Twotoz/C5VRX/v5/README.md

# C5VRX-5

Analog 5.8 GHz FPV receiver on one Seeed Studio XIAO ESP32-C5 with a passive
6-bit resistor DAC: live FM video in, composite PAL/NTSC out for goggles.

C5VRX-5 uses one live demodulator. Its receive-chain evidence is recorded in
[docs/FINDINGS.md](docs/FINDINGS.md). Console `J` additionally enables the
read-only [IQLaneFusion research shadow](docs/IQLANE_FUSION.md): analytic
model proposals, off by default, with no lane/gain/decoder actuator. This
research is not a demonstrated video or range improvement.

## Experimental stacked PR

This branch contains an opt-in **U85G near-origin pair assistance** test on the freshly
measured WIDE VTX profile. Other profiles keep U85Q. The physical
pipeline is unchanged; outdoor range improvement is not measured, and
some synthetic echo/fade cases regress. Read [PAIR_DEMOD.md](docs/PAIR_DEMOD.md)
before the A/B test. The default build keeps the exact #196 demodulator. Build with
`-DC5VRX5_PAIR_ASSIST=ON` to test U85G on WIDE profiles. This experiment is not ready for production.

The branch also includes an [offline demod architecture search](docs/DEMOD_SEARCH.md).
It generates phase-only and predictive phase/frequency models within one 2 KiB
shared LUT, then rejects candidates that lose sync or strong-signal quality.
Screening uses the actual ADC folding; independent full-field tests gate export.
Running the search does not change the active firmware demodulator.
`lut_evolve.py` additionally evolves the complete LUT and arbitrary input-bit
selection, without requiring angular tokens or phase/frequency state meanings.
The follow-up explores 2..10-bit observation tokens and up to eight retained
state bits using unused DAC padding. Its 434-genome full-field run found no
passing LUT. A separate floating predictive host reference passes synthetic
quality/sync gates with +2.6..3.1 dB mean weak-case luma SINAD gain. This is a
research target, not live C5 firmware or measured outdoor range.

## Experimental AWD6 demodulator (opt-in)

[AWD6](docs/AWD6.md) is a new TX BitScrambler demodulator for **wide VTXs**:
the 50-ns phase step from counter A, with its half-turn ambiguity resolved
around a slowly tracked centre. Same pipeline, cadence and DAC window as
U85Q. Console `W` selects it for the WIDE profile (stored, reboots); every
other profile keeps U85Q. Host simulation only so far; not yet tested on a
board and no range claim.

## What it does

- **U85Q demodulator** in the TX BitScrambler: an untrained 32-phase tracker
  that keeps the picture locked across VTX deviations, off-centre carriers
  and multipath instead of dropping out. Board-validated on real video.
- **Fixed ultrafine IQ** (ADC bits 9,6,5,4) at 40 MS/s, no CPU in the sample
  path.
- **Direct Gain V5**: firmware gain with a zero-write healthy band, fast
  overload handling and a learned, persisted gain map.
- **Narrow analog filter**, measured once per board at startup: the lowest
  noise bandwidth that still passes 12 MHz (plus a 10 MHz class for
  low-deviation VTXs; simulation-based, board test pending).
- **Calibration only at startup**: anything that interrupts the picture
  runs once after power-on (only what is missing) or from the menu item
  CALIBRATE, never during flight. The goggles show what it does and how long.
- **VTX-matched profile** (narrow for low-deviation VTXs, wide 16 MHz for
  wide ones) **only from a fresh measurement**: every boot starts
  with the default profile; the narrow profile is chosen only when this
  boot measured the VTX in the startup phase. Later readings are kept as
  pending for the next boot, never switched in flight.
- **Field diagnostics** (serial `D`, `R`): what is really active, and why
  each dropout happened as far as the receiver can tell
  ([docs/FIELD_TEST.md](docs/FIELD_TEST.md)).
- **DC correction for every gain row, also with the VTX on**: missing rows
  are measured once at startup on a quiet channel, so far-out (high gain)
  reception has no uncorrected DC.
- **Automatic receive-chain care**: per-gain DC correction, DC drift
  tracking, sampling-phase check, AFC that centres the VTX.
- **Simple menu**: band, channel, scan, video standard, exit.

## Hardware

XIAO ESP32-C5. DAC on D4..D9 (GPIO 23, 24, 11, 12, 8, 9; LSB first) with
8.2k / 3.9k / 2k / 1k / 470R / 240R and a 200R load, as in C5VRX-3/4. The
receiver uses the ESP32-C5's own Wi-Fi radio; no extra RF parts.

## First boot

1. Flash (below) and power the receiver, best with the **VTX off**, for up
   to two minutes: the goggles show CALIBRATING with the time left. With a
   VTX on it calibrates the filter on a quiet channel and comes back.
   Results are stored; later boots skip what is already measured.
2. Switch the VTX on. Without a stored channel the receiver starts on
   A1 (5865 MHz); use the menu or scan to find yours.

## Controls (BOOT button)

| live video | in the menu |
| --- | --- |
| short press: next channel in the band | short press: next item |
| hold 0.6 s: open the menu | hold 0.6 s: do the item |

Menu items: **BAND** (next band), **CHANNEL** (next channel), **SCAN**
(all 48 channels, picks the strongest centred analog video), **VIDEO**
(AUTO / NTSC / PAL for the menu picture; AUTO follows the camera),
**CALIBRATE** (on the ground: measure again), **EXIT**.
The menu closes by itself after 30 s without a press.

## Flashing

- **Web flasher**: [twotoz.github.io/C5VRX](https://twotoz.github.io/C5VRX/),
  tab **C5VRX-5**, *Full firmware* when coming from another generation.
- **ESP-IDF 6.0.2**: `cd v5 && idf.py build flash`. The filter and DC
  correction need the exact libphy of IDF 6.0.2 (checked at build time);
  with another PHY they are disabled and the build warns.
- A running receiver enters USB download mode from the console key `` ` ``
  (`tools/enter_download.py`), so no BOOT button is needed for flashing.

## Serial console (USB, 115200)

`T` status, `D` range/health report, `R` per-second FIELD_DIAG lines on/off
(`tools/field_diag_compare.py`), `I` IQ snapshot
(`tools/capture_iq_snapshot.py`), `o` menu, `c` next channel, `b` next band,
`s` scan, `F` calibrate again (as the menu item), `L` bench-only IQ lane
comparison (video stops ~3 s), `` ` `` download mode, `h` help.

## Credits and license

C5VRX-5 is part of [C5VRX](https://github.com/Twotoz/C5VRX) by Twotoz and
the C5VRX contributors; the official website
([twotoz.github.io/C5VRX](https://twotoz.github.io/C5VRX/)) has the project
and its Discord invite. It builds on C5VRX-2..4 (the continuous MODEM_DIAG
to BitScrambler video path, Direct Gain V3-V5, the PAIR schedule and the
U85Q study of PR #190), on zerowidth/C5VRX PR #3 (interference-burst gate,
sampling-phase probe, off-grid channel tuning), on Louis Hitchcock's staged
overload recovery (C5VRX #182/#184), and on ESPARGOS esp-sdr (GPL-3.0) for
the C5 RX filter control. Espressif supplied the GDMA EOF fix
(espressif/esp-idf#19091).

Like the rest of this repository, C5VRX-5 is licensed under
**GPL-3.0-only** (see `LICENSE` at the repository root). The GPL allows
commercial use, including selling receivers with this firmware, provided
the source (with your changes) is passed on under the same license.
