Twotoz/C5VRX/v5/research/README.md

# Where can C5VRX-5 firmware still gain range?

For the follow-up automated **architecture search**, see
[DEMOD_SEARCH.md](../docs/DEMOD_SEARCH.md) and `demod_search.py`. It uses the
actual ultrafine folding quantizer and per-case sync/quality rejection gates.
The older tables below retain their original clipped-quantizer assumptions;
they are not measured receiver sensitivity or a guarantee of field range.

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

## 1. Sync is not the bottleneck

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

## 2. The picture limit depends on the VTX deviation

Usable threshold, then the combined range limit (worse of lock/usable):

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

## 3. Strong signal and carrier error (`data/strong.txt`)

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

## 4. Tracker gain alone (`data/tracker.txt`)

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

## 5. What C5VRX-5 does with it

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

## 6. Open field: AFC re-acquisition at weak signal (`afc_bias.py`)

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

### Coherence is not C/N

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

## 7. Open field: propagation, the larger effect

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

## 8. Open field: Direct Gain through fast nulls (`test/test_gain_fade.c`)

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

## 9. Open field: what gives the most range (`field_antenna.py`)

This section uses textbook physics and data from datasheets and listings,
not C5VRX measurements.

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

Model ranges (25 mW, 2 dBi RHCP VTX, -93 dBm, 95 % of positions):

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

**Other levers.**

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

## 10. Wide VTXs: the default 12 MHz class clips them (`range_study.py wide`)

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

## 11. Where it is good and where it is bad (`situations.py`)

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

**Bad, and what was done about it:**

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

## Not firmware levers

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

## Reproduce

```
python range_study.py filter  data/filter.json
python range_study.py sync    data/sync.json
python range_study.py tracker data/tracker.json
python range_study.py matched data/matched.json
CNRS=0,2,4,8,12,16,20,25 python range_study.py strong data/strong.json
```

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

## Diagnostic cliff follow-up (PR #196, 2026-10-11)

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

See `v5/docs/FIELD_TEST.md` for repeated 0.5–1-dB conducted attenuation sweeps,
independent IQ/video/output thresholds, real-IQ floating/bit-exact replay and
outdoor antenna/height A/B/A. RF offset readback, analog BW/passband and DC
validity across profiles still require bench measurements. No measured range
gain or physical picture-cliff fix is claimed by the diagnostic code.

## 10. Demodulator follow-up: U85G (draft, opt-in)

The stacked #196 follow-up screened 252 analytic formulas and built a
near-origin-only PAIR4411 decoder that uses B's signs. Independent full
PAL/NTSC rasters show small AWGN gains on wide VTXs, but a synthetic echo
case regresses badly in sync. It is consequently **OFF by default**, not
a claimed field-range fix. See [PAIR_DEMOD.md](../docs/PAIR_DEMOD.md) for
numbers, rejected candidates, the generator, reproducible data and the
physical A/B gate. Medium/narrow firmware profiles keep U85Q even in an
opt-in build.
