Twotoz/C5VRX/v5/docs/IQLANE_FUSION.md

# IQLaneFusion: analytic research implementation

C5VRX by Twotoz and the C5VRX contributors. This extends the untrained
U85/PAIR formula work in PR #190, the older adaptive lane/gain controller,
and the Gaussian-cell/history study in `experiments/c5vrx-4/PHASE8_THREE_BUNDLE.md`.
Source: https://github.com/Twotoz/C5VRX . Official project and Discord invite:
https://twotoz.github.io/C5VRX/ . Existing GPL/source notices remain applicable.

## Implemented, and what is not proved

The host implementation is executable: exact Q10 bit extraction, union-cell
Gaussian likelihood integration, a factorized phase/frequency tracker retaining
multiple hypotheses, mathematical candidate/gain search, sequential route-write
replay, decision persistence, U85Q comparisons and a compressed BS experiment
generator. No fitted weights, camera training or online reward learner.

Firmware has an opt-in passive shadow, not live lane fusion. `J` toggles it;
`T` reports it. It consumes 64 bytes sampled from the existing completed
control snapshot at most once per second. There are no extra IQ copies and no
actuator calls. The normal fixed-ultrafine U85Q path is unchanged. Hardware
timing, real displayed video and RF attenuation/range are not validated here.

The reference is NOT a demonstrated replacement for U85Q. The synthetic
fade probe currently regresses substantially despite improvements in some
nominal/weak/fold cases. That negative result is preserved in the JSON report.
The physical-ADC moving PAL test at synthetic C/N6, seed196, 64 phases,
known amplitude/noise and one fixed gain gives U85Q 4.71 dB luma SINAD
versus reference 3.39 dB; both goggle-model sync fractions are 1.0. This
is another regression and a reminder that sync alone is not picture quality.
Do not flash the compressed prototype as an improvement based on the host
reference: the two algorithms have different state and have not been shown
equivalent. This first implementation does not complete safe live adaptation.

## Observation model

`iq_lane_fusion.py` implements flooring and ADC saturation at [-512,511]
followed by the actual selected physical bits. A captured nibble represents
a union of ADC intervals, including the infinite saturated end tails.
For example ultrafine code1 includes [16,32), [144,160), [272,288), [400,416).
ADC pairs (144,16) and (16,144) have equal radius and the same raw byte but
phases 6.34 and 83.66 degrees. A midpoint signed-nibble interpretation cannot
recover that information.

The reference models `z=A*exp(j*phase)+DC+noise`, optional known I/Q ratio and
skew, independent Gaussian axis noise, and explicit radius hypotheses. It
integrates EVERY interval rather than fitting LUT entries. Receiver noise may
actually be correlated or non-Gaussian; model mismatch is not waived by calling
this mathematical. Radius hypotheses are equally weighted in the cell model;
their temporal correlation and phase/frequency correlation are not retained.
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
