Twotoz/C5VRX/research/sync_reference_tip.py

"""C5VRX by Twotoz/contributors: controlled first-EQ reference regression.

Compare the actual reference-bound core with a temporary legacy-scoring copy.
The actual mapped decoder and external waveform gates remain identical.
This does NOT validate live generation/ownership, noisy prefixes or LCDs.
Run with a C11 compiler, e.g. inside the pinned IDF image.
"""
from pathlib import Path
import argparse
import csv
import hashlib
import io
import json
import subprocess
import tempfile

ROOT = Path(__file__).resolve().parents[1]


def main():
    parser = argparse.ArgumentParser(description=__doc__)
    parser.add_argument('--output', type=Path)
    args = parser.parse_args()
    core_path = ROOT / 'main/sync_flywheel.c'
    matrix_path = ROOT / 'research/sync_output_transition.c'
    core, matrix = core_path.read_text(), matrix_path.read_text()
    needle = 'r->reference_lut ? r->reference_lut : r->decoder_lut'
    assert core.count(needle)==2, 'actual prefix/score source changed: review comparison'
    legacy=core.replace(needle,'r->decoder_lut')
    outputs={}
    with tempfile.TemporaryDirectory() as directory:
        folder = Path(directory)
        for name,source in [('actual',core),('legacy',legacy)]:
            (folder/(name+'.c')).write_text(source)
            runner=folder/(name+'_matrix.c')
            runner.write_text(matrix.replace('#include "../main/sync_flywheel.c"','#include "'+name+'.c"'))
            binary=folder/name
            subprocess.run(['cc','-O2','-std=c11','-Wall','-Wextra','-Werror',
                '-I',str(ROOT/'main'),str(runner),'-o',str(binary)],check=True)
            outputs[name]=subprocess.check_output([str(binary)],text=True)
    rows=list(csv.DictReader(io.StringIO(outputs['actual'])))
    old=list(csv.DictReader(io.StringIO(outputs['legacy'])))
    key = lambda r: tuple(r[k] for k in ('kp', 'lp', 'output', 'pal', 'kind'))
    previous = {key(row): row for row in old}
    assert len(rows) == len(old) == 1280
    unity = [row for row in rows if row['output'] == '0']
    assert all(row == previous[key(row)] for row in unity), '1x result changed'
    groups = []
    for lp in range(2):
        for level in range(10):
            group = [row for row in rows if row['lp'] == str(lp) and row['output'] == str(level)]
            groups.append(dict(lp=bool(lp), output_level=level,
                **{name: sum(int(row[name]) for row in group)
                   for name in ('cases', 'normalized_width_ok', 'bootstrap_refused', 'tail_changed')},
                baseline_bootstrap_refused=sum(int(previous[key(row)]['bootstrap_refused']) for row in group),
                max_tail_span=max(int(row['max_tail_span']) for row in group)))
    result = dict(
        scope='Actual reference-bound core versus legacy scoring; mapped decoder; deterministic strong prefixes only',
        source_sha256={str(path.relative_to(ROOT)): hashlib.sha256(path.read_bytes()).hexdigest()
                       for path in (core_path,matrix_path,ROOT/'main/output_level.h',ROOT/'main/sync_lut_context.h')},
        rows=len(rows), decode_cases=sum(int(row['cases']) for row in rows),
        unity_rows_exact=len(unity), groups=groups,
        reference_binding_implemented=True, live_context_admission_validated=False,
        non_lp_supported=False, physical_lcd_validated=False,
        conclusion='Reference ranking removes half-scale construction rejection; full binding has separate actual-source tests, live timing and display remain unverified')
    if args.output:
        args.output.write_text(json.dumps(result, indent=2) + '\n')
        args.output.with_suffix('.csv').write_text(outputs['actual'])
    print(json.dumps({name: result[name] for name in ('rows', 'decode_cases', 'unity_rows_exact', 'groups')}, indent=2))
    return int(any(row['lp']=='1' and (row['normalized_width_ok']!=row['cases'] or int(row['bootstrap_refused'])) for row in rows))


if __name__ == '__main__':
    raise SystemExit(main())
