Twotoz/C5VRX/(commit log)

2026-09-24 tools: preserve Golden360 capacity oracle
2026-09-24 Run Golden Phase5 in two BitScrambler slots
2026-09-25 Capture both raw IQ samples in two-bundle Golden FSM
2026-09-25 feat: probe alternating middle Phase5 and enable Static-A Relative Golden on C5 (#76)
    * Probe alternating middle and endpoint relative worker Phase5 on C5
    * feat: implement Static-A Relative Golden with freed opcode slots
    * docs: record hardware pass of middle-sample probe and static-A relative golden
2026-09-26 fix(bsasm): eliminate overlapping output bit assignments in Phase5-360 worker bundles
    [gen_phase5_360.py]
2026-09-26 fix(phase5-360): eliminate false clamps and LUT collisions to cure rainbow artifacts
    [gen_phase5_360.py]
2026-09-26 feat: implement Phase5-360 Option A rail demodulator, fix Pages mirror resilience, and record PR #72-#77 findings
    [gen_phase5_360.py]
2026-09-26 feat(gain): implement Feed-Forward Direct Gain control with Inverse-Q4 transfer and self-calibration
2026-09-26 feat(gain): add Carrier Authenticator protection and interactive RSSI gain oracle probe ('R') (#80)
2026-09-26 feat(demod): Phase5c Static Squelch & Smooth Direct Gain Slew Rate (#81)
    * feat(demod): Phase5c static squelch & smooth Direct Gain slew rate
    - Phase5c (Phase5 Correction): Map impossible FM video phase deltas (|delta| >= 12 bins, >135° in 25ns) to Golden blanking pedestal (DAC code 20) with smooth roll-off instead of rail-slamming 0/63, completely eliminating harsh salt-and-pepper static sparks.
    - Smooth Gain Slew Rate: Implement slew-rate limited transitions (+5 / -6 steps per 50ms tick) during active carrier tracking to eliminate luminance jumps and DC transient flicker, while retaining single-hop instant acquisition and fast emergency clipping cuts.
    - Display desired target gain in Dir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
    [direct_gain.c, gen_phase5_360.py, validate_build.py, video.c]
2026-10-07 fix(ci): recognize HC50 BitScrambler source artifact
    [validate_build.py]
2026-10-12 feat(c5vrx5): AWD6 adaptive-wrap demodulator, opt-in for the WIDE profile
    New TX BitScrambler demod: 6-bit 50-ns endpoint phase step in counter A
    (ADDCTIAH/LDCTIAH, sign alternating by span parity), half-turn ambiguity
    resolved around a tracked centre (6 levels, escape rule against
    wrong-branch lock). Same two bundles, read16/write16 per pair, LUT16 and
    -6..+9 MHz DAC window as U85Q; no CPU sample path.
    - tools/gen_awd_demod.py generates main/awd6.bsasm (ESP-IDF 6.0.2 bsasm OK)
    - tools/bs_emu.py: bundle-level emulator, bit-exact on U85Q programs and
    the board counter probe
    - research/awd_study.py + three archived holdouts (two superseded designs)
    - console W / NVS c5vrx5/demod selects AWD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
2026-10-13 fix(web): gate live restart bench command during calibration
2026-10-13 fix(c5vrx5): resume loss raster with current verified ladder target
2026-10-13 perf(c5vrx5): reuse prepared NO SIGNAL DMA raster between fades
2026-10-13 diag(native): explain board refusal before AGC handoff
2026-10-13 diag(range): retain actual IQ and expose DCO filter context
2026-10-13 docs(range): record verified flash and pending board startup
2026-10-14 fix(calibration): reject false DC circles and stop disruptive live phase scans
2026-10-14 diag(sync): bracketed DMA memory-frontier readback and byte-granular RX tails
    Physical e9130ae probe showed RX tail nodes of 2062 bytes; RX offsets/lengths are now byte-granular. The T probe brackets descriptor capture with BF0/DONE/OUT_DSCR/OUT_STATE and PCR clock tuples, refuses unstable/unknown clocks and link mismatches, and uses scheduler ownership instead of the analog PHY lease. Diagnostic only: mem_writes_safe=0.
2026-10-14 fix(calibration): verified live-carrier DC trial with readback and rollback
    Replaces the polarity-assuming thermal nudge: two qualified carrier centres, one-code trial with gain/pair readback, fresh improvement check within 2 ms, otherwise verified restoration. RAM-only; board validation pending.
2026-10-14 feat(output): add 0.5x output level to prevent noise clipping at range
    Adds 0.5x half-scale setting (level 9) with pivot 21 and scale factor 1. Prevents wide VTXs and range-edge FM noise from hitting 0/63 DAC rails, avoiding lost monitor sync during weak reception. Bit-exact 1.0x (level 0) and existing 1.5..5.0x levels are preserved.
2026-10-14 docs(review): track PR feedback and wire evidence regressions
2026-10-15 docs(sync): retain filtered physical benchmark transcript
2026-10-15 research(sync): validate actual read footprints after DONE-cadence turns
2026-10-15 diag(sync): distinguish timer cadence from delayed service wakes
2026-10-15 docs(sync): retain acquisition IRAM and exact-rejection board evidence
2026-10-15 fix(sync): size read-only task stack from target call-chain evidence
2026-10-15 perf(sync): validate conservative read spans without per-sample bookkeeping
2026-10-16 research(sync): quantify sync-flag codec cost and record current board limits
2026-10-16 fix(sync): anchor protected publication history at completed DMA data
2026-10-16 feat(sync): add resumable pulse engine and manual DAC output-enable probe
2026-10-16 fix(sync): temporarily clear and exactly restore DAC weak pulls during gate probe
2026-10-16 feat(sync): add long manual gate and filtered native DAC probes
2026-10-16 fix(sync): accept native OE routing and trace gate timing failures
2026-10-16 fix(sync): arm gate interrupts before the unchanged pulse deadline
2026-10-16 docs(sync): record independent native mirror board evidence
2026-10-16 docs(sync): record marker clock board qualification and unresolved phase proof
2026-10-16 feat(sync): bound native clock offset with two filtered marker edges
2026-10-16 docs(sync): archive filtered clock bounds from forty C5 trials
2026-10-16 feat(sync): add conditional clocked output bench and board evidence
2026-10-16 fix(sync): filter RMT chatter and capture bounded native pulse history
2026-10-17 fix(sync): report interrupted comparator captures as failed
2026-10-17 fix(sync): reuse finite probe storage after observer allocation
2026-10-17 fix(sync): retain phase across RMT rearms and track rational H grid
2026-10-17 fix(sync): guard GPIO2 marker edge brackets from ISR stretch and expand LP_SRAM RX ring
2026-10-17 fix(sync): allow immediate reacquisition and jump on VTX power cycle; revert RX ring to 12
2026-10-17 fix(sync): lock flywheel phase across epoch rearms and prevent blind OE clamp
2026-10-17 fix(sync): stop flywheel rolling with a camera-phase guard; restore CI
    The live flywheel suppressed a repair only when a native edge landed
    within +-4 us of its own tip. A camera present but off the held grid
    (VTX power cycle, long static, drift without updates, or a model whose
    V anchor was only coasted) then got a competing sync: slow horizontal
    roll and the top of the picture at the bottom.
    - sync_phase_guard.h: coherent off-grid native H yields the OE and
    re-anchors H; two fields with the same V offset re-anchor V by whole
    halflines; small coherent H offsets are trimmed. Noise cannot score.
    - Models move the grid only with a fresh V anchor (m.valid).
    - Revert the 40 ms authority exp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
2026-10-17 perf(ram): share control and calibration scratch buffers
    Measured (idf.py size, esp32c5): HP SRAM -4,088 bytes, LP SRAM
    (RTC_FAST, also boot heap) -5,008 bytes.
    - control.c: video-watch snapshot and control window are used strictly
    in sequence on the control task and now share one buffer; the scan
    uses a separate area of it instead of a 4 KiB malloc.
    - calibration.c: noise-envelope probe and live DC trim window share one
    RTC_FAST buffer (calibration task, never nested); the wanted DCO
    context is a header comparison instead of a 910-byte table.
    Claude-Session: https://claude.ai/code/session_01RpttEg9k7iYxfpyyo5yKHu
2026-10-17 feat(sync): holdover PLL for the live flywheel period
    The holdover period came from the probe's 32..64-line fit, quantised to
    1/64 tick per halfline (up to ~24 us/s of drift in static, a full line
    in ~2.6 s). While the camera is aligned, every guard trim and model slew
    is phase the grid lost against it; over >= 1 s and >= 2000 aligned pulses
    (trims + slews + residual) / halflines is the period error.
    - sync_clock_pll.h: integer estimator, 200 ppm bound per window,
    restarted by any re-anchor or takeover.
    - sync_live_clock.h: 16-bit iterator fraction (1/50000 tick/halfline).
    - sync_live_output.c: PERIOD publication; slews keep the running period
    while measuring and use the PLL period once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
2026-10-17 feat(sync): guard camera acquisition and field-spaced V re-anchor
    Board captures often showed camera_qualified=0 (the strict EQ/broad/EQ
    grammar failed at range), and without a qualified model the flywheel
    never repaired anything.
    - The camera-phase guard now also runs on the nominal clock before
    authority: coherent camera H re-anchors H, V re-anchors on two
    field-spaced broad observations, and authority is granted once H is
    aligned (>= 12 pulses) and V is confirmed at the grid's own broad slot
    on two field-spaced fields, with nothing unapplied.
    - V evidence must repeat 1..4 whole fields apart (+-128 ticks); a
    half-field or later coincidence no longer re-anchors V.
    - Host: camera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
2026-10-17 fix(sync): require current H and V evidence for guard acquisition
    In-phase H confidence only decayed on off-phase pulses, so with no
    pulses at all it stayed high and could combine with later V evidence.
    H confidence older than one field now restarts from zero, and the grant
    needs H within ~10 lines (the V interval carries none for up to ~9) and
    V within two fields of the deciding pulse. Host: camera H only for
    100 ms then V only granted authority before and is refused now.
    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
2026-10-17 docs(sync): note current-evidence requirement for guard acquisition
    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
2026-10-17 feat(receiver): Direct Gain V6, manual gain mode, flywheel camera yield, menu memory
    Board readout on 6285771 (A1 NTSC, strong camera) showed G21 -> G63 after
    every fade with up to 742 per mille clipping and a staged walk back; the
    observer rebinds the gain model on every AFC step/PHY lease, which cleared
    the fade state. The flywheel repaired more tips than it suppressed on a
    present camera (held grid drifted off it), shifting top lines and losing
    sync after a while. The menu failed with ESP_ERR_NO_MEM at 7 KiB free.
    - Direct Gain V6: last healthy gain survives tracking resets on the same
    channel/filter/lane/table; lost carrier holds 10 ms then climbs 8 indices
    per 3 ms (still reaches t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
2026-10-17 fix(menu): progressive one-field menu raster and small descriptor chunks
    With the flywheel active the menu (and the calibration status screen that
    shares its raster) still failed with ESP_ERR_NO_MEM: 1.5-KiB 64-byte-aligned
    chunks stopped after ~14 KiB with 7 KiB left in fragments.
    - Menu raster: one progressive field (NTSC 262 / PAL 312 lines, the
    240p/288p form consoles emit; both interlaced fields showed the same
    picture). Burst closes per field. Chain 1499 -> 748 (NTSC) and
    1811 -> 905 (PAL) descriptors.
    - Descriptor chunks 384 B, word aligned (internal SRAM is not cached on
    the C5; sync_dma_c2m rounds itself).
    - Failure log reports internal/DMA free, largest block and chunk cou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
2026-10-18 fix(sync): per-type sync ownership and checked menu entry
    Review follow-up (PR #212 comment 6243377904): shifts/rolling on a
    healthy camera with SyncRescue on, and the menu allocating next to a
    still-active flywheel.
    Sync ownership, per tip and per pulse type:
    - The 20 ms camera-present yield skipped every tip (V/EQ/broad too) on
    periodic H alone and resumed 20 ms after a loss. A synthetic H tip now
    needs camera H seen in phase on this grid within 5 s; a V/EQ/broad tip
    additionally camera V confirmed at this grid's broad slot. Without that
    evidence nothing is clamped (camera_yields). Re-anchors clear the trust
    until confirmed; a qualified model or guard acquisition grants it.
    - Wi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
2026-10-18 refactor(sync): camera-phase guard is the single flywheel grid owner
    The ISR's native source was gated on the probe's strict H/V model, which
    rarely qualified on the board, so camera edges never reached the ISR and
    tips were repaired over a strong camera. The source now reflects only
    marker/RX validity (false during a coasting restart).
    The probe-model publication path (update/slew/reseed from the model,
    native_fresh, periodic-H presence) is removed: output always starts on the
    nominal grid without authority, the guard acquires, trims, re-anchors and
    grants authority, and camera presence is the guard's in-phase H. Four
    unlocked H re-anchors within 20 ms restart the grid on the other standar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
2026-10-18 fix(sync): camera-phase guard counts evidence per line, not per pulse
    Measured on the host with the real output code: from about one noise pulse
    per line the per-pulse up/down score lost a present camera and re-anchored
    44 times in 10 s; h_jumps also counted every trim, and the holdover PLL
    learned from random in-window pulses in static.
    The guard now keeps a per-line phase histogram (32 bins, running mean over
    64 lines) with a 7-sigma contrast threshold from the measured noise rate,
    a second histogram on the other standard's line period (PAL/NTSC switch),
    a median-type fine phase tracker, and trims gated on 4 standard errors
    (exact integer test). The PLL learns only from camera H held in p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
2026-10-18 fix(menu): interlaced menu that fits beside the flywheel, relock gap, flywheel setting
    - Menu raster: interlaced (BT.470 frame) is the default again; the
    progressive field is only a fallback when its chain cannot be reserved.
    The operator's goggle showed the progressive menu briefly, then inverted
    and went black.
    - 150 ms flat level without sync between live video and the menu (both
    ways) so the goggle drops the camera lock and locks fresh.
    - Diagnostic history moves to LP SRAM (control task only, no DMA/ISR):
    DMA-capable heap with the flywheel active 15 -> 19.9 KiB, enough for the
    interlaced NTSC chain (18 KiB). Status prints heap_dma/heap_lp.
    - Flywheel setting: menu FLYWHEEL a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
2026-10-18 chore(pr212): remove benches, abandoned ring-writer path and raw research data
    Make the PR lean for merging (operator request 2026-10-18).
    Removed firmware (none on main, all PR-added):
    - the abandoned CPU ring-writer route: sync_flywheel.c, sync_period_bank.h,
    sync_tip_policy.h, pulse find/walk/synth, read validation, repair ledger,
    memory frontier, DMA progress, raw access/history reader tokens, and the
    read-only W sync service;
    - console benches J, Z/z, Q/q, Y/y, V, i, W, u, t, the native AGC bench (~),
    the opt-in black NO SIGNAL fallback (N) and the LCD_AB restart bench (B);
    - unconnected native witness, unused planner paths and probe entry points.
    Kept: Direct Gain V6, GAIN/FL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
2026-10-24 hw: add C5VRX_JACK_DIY Fat Shark carrier board and production files
    - 42.51 x 28.80 mm carrier board fitting standard Fat Shark module bays
    - Socketed Seeed Studio XIAO ESP32-C5 (2x7-pin 2.54mm header) facing USB-C left
    - 4-pole TRRS 3.5mm AV jack (PJ-320D) facing left under the XIAO
    - 6-bit R-2R ladder (R1-R7) and filter C1 using axial 1/4W through-hole footprints
    - 9-pin right-angle male header for Fat Shark goggle bays
    - Solder jumper SJ1 for 5V bay power
    - Includes KiCad schematic/pcb, footprint library, 3D step model, BOM, Gerbers, and renders
2026-10-24 Add optional PARLIO sample clock output on GPIO2
2026-10-24 Show flywheel as disabled when sample clock is enabled
2026-10-24 Hide flywheel menu item in sample clock builds
2026-10-24 Preserve explicit SDKCONFIG_DEFAULTS for sample clock builds
2026-10-25 Fix CMake defaults CI step and add 7/8-bit DAC pin choices
    The main merge dropped the export.sh line that put CMake on PATH for
    test_build_defaults.py; run it in its own IDF-initialised step.
    The sample-clock option becomes a menuconfig choice: 6-bit, 6-bit +
    clock, 7-bit (extra LSB on D10/GPIO10) + clock, or 8-bit (GPIO10 and
    GPIO2) without clock. P64 still emits 6-bit codes, so the extra ladder
    bits are reserved as driven-low outputs; 7/8-bit builds stop with an
    error until PR #259 moves the IQ I-LSB off GPIO10.
    Claude-Session: https://claude.ai/code/session_019jBdWYTR36XrxpwW8WSJ4P
2026-10-25 Document GPIO2 as one shared clock/DAC/future-button pin
    With the sync flywheel removed, GPIO2 no longer has a sync role: it is
    the 40 MHz clock pin for now, with an 8-bit DAC LSB or a future button as
    the alternatives.
    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
2026-10-29 Decoder: U85Q selectable next to U80P64-R1 (menu DEMOD, console m)
    Operator decision 2026-10-28: the archived untrained U85Q comes back as a
    second fixed decoder for like-for-like board comparisons; no kp ladder, no
    LP. U80P64-R1 stays the default.
    - main/u85q.bsasm is research/legacy_demod/u85q.bsasm byte for byte (the
    program the host models score as U85Q); main/u85q_table.h is its LUT.
    - transport.c picks program and LUT per decoder. A switch is the same
    verified halted restart as OUTPUT and profiles, behind the shared 5 s
    guard; a rollback returns to the last verified decoder with its own LUT.
    The flight log reports the verified decoder (wire id 1, U85Q).
    - Menu DEMOD (P64/U85Q,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
2026-10-29 FINDINGS: U85Q on the board and the picture measure (walks 296, 300)
2026-10-29 Add reversible PHY noise experiments and record bias/current findings
2026-10-29 PHY noise: record the loop-cap and spur-slot board runs
    Loop cap (suite g): 7 settings, +0.019..+0.056 dB of noise against shams -0.064..+0.044, no reduction. Spur slot 0 (suite h): +0.003 / -0.012 dB, no effect; slot 1 skipped (already active); slots 2..3 rejected with incomplete measurements, still untested. Evidence JSON now holds all seven runs.
2026-10-29 EXPERIMENTAL plan: field-only candidates
    Settings a VTX-off bench cannot score (carrier, video, deviation, movement): gain writes in H-sync, LEVEL target/release, gain rate/cap, sentinel threshold, DC servo speed, analog filter code, tune offset, AFC speed, fixed sample phase, sync clean, erasure output and flight-log cadence.
2026-10-30 Add experimental D10 sample clock with D3 DAC bit 2 routing
2026-11-10 AUTO OUTPUT, survival row for LEVEL and receiver pause records
    AUTO OUTPUT (output_auto.h, EXPERIMENTAL > AUTO OUTPUT, default ON): the
    video level is set from the live decoder's measured sync tip, sync depth
    and peak white instead of the fixed 1.0x map, which leaves a deviation
    0.69 VTX with a sync of ~5.5 DAC codes. Applied as an affine output word
    by the existing verified restart, guard and rollback; held on weak or
    missing video; a manual OUTPUT level other than 1.0x wins.
    LEVEL: a carrier at or under 6 dB C/N, or none, scores the top row
    highest (the known high-gain state).
    Every receiver pause is recorded with owner and duration (FLOG_E_PAUSE,
    T PAUSES).
    Host tests only; no board, v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
2026-11-10 U50P64-R1 range decoder, AUTO OUTPUT span hold and findings
    U50P64-R1 (research/u50p64.py, main/u50p64.bsasm): the U80P64-R1 program
    and formulas with loop gain 0.50, selectable in DEMOD (never automatic,
    P64 stays the default). Host model, fresh seeds: luma SINAD +2.0..2.7 dB
    at deviation 0.7 for C/N 0-9 dB with equal line lock, +0.9..1.6 dB at
    1.0, a loss from 1.2; a session measured at deviation >= 1.10 falls back
    to U80P64-R1.
    AUTO OUTPUT keeps the largest composite span of a context, so picture
    content cannot make the level hunt.
    docs/FINDINGS.md records the reading of the edge evidence, the host
    results, what was left out and the deciding board checks. No board
    result.
    Co-Authored-B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
2026-11-10 AUTO OUTPUT sync-tip room, U50P64-R1 default and edge window study
    AUTO OUTPUT put the sync tip on DAC code 3: at the range edge the noise and
    FM clicks under the tip were cut on one side and the host goggle model lost
    lines that OUTPUT 1.0x keeps (research/output_tip_headroom.py). The tip now
    sits on code 16 with peak white still on code 60.
    U50P64-R1 is the boot decoder (operator decision 2026-11-10), kept in NVS
    demod2 so a choice stored under the old key does not hide the new default;
    the deviation fallback to U80P64-R1 is unchanged.
    research/edge_window.py: fold-free window per IQ lane at one analog gain and
    the cost of residual DC, with the unchanged U80P64-R1 table. Host only.
2026-11-13 fix(c5vrx5): gain floor below G20 for an external LNA close in
    With an external LNA the close-in gain moves from G21/G24 into G2-G9, where
    two limits sat that the bare board never reached:
    - dg_reset_context clamped the core to >= G20, so with the hardware under
    G20 receiver.c saw a mismatch and rebound the gain core every window.
    The floor is now G2 (apply_target, KEEL-1 home rows).
    - LEVEL's level histogram ended at +80 dB (about G9); stronger carriers read
    as +79 and LEVEL held a row folding every window. AGC_LMAX_DB is now +100.
    New host test test_agc_strong (CI). test_agc_compare output unchanged.
    Host model only; no board result.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
2026-11-13 feat(c5vrx5): STRONG LANE, a coarser IQ lane when the gain floor still folds
    After the gain floor fixes an external LNA still degraded the picture at
    about 20 cm (board report). With the gain on rows 0-9 and no lower row
    asked, a carrier that keeps folding now moves to the fine and then the
    coarse IQ lane (6 / 12 dB more room, a GPIO-matrix route, no PHY write);
    a small or absent carrier returns to ultrafine and the normal gain control.
    A pause owner, a fixed gain or the pair sweep releases it at once.
    EXPERIMENTAL > STRONG LANE (default ON), console T: STRONG_LANE. Policy in
    main/strong_lane.h with test/test_strong_lane.c (CI). Not reached without
    an LNA. Host policy only; no board result.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
2026-11-13 research(c5vrx5): strong carrier on the gain floor, per lane (STRONG LANE model)
    research/strong_lane.py reuses the exact ADC bit model and decoder of
    edge_window.py: a folded lane loses 10-14 dB of luma SINAD, the lane STRONG
    LANE settles on stays within ~1.5 dB of an in-window carrier up to the ADC
    range (+12 dB). Host model only: no analog compression, no route transient.
    Claude-Session: https://claude.ai/code/session_01SbUcqbhLbH4r1yRpUPnGnQ
2026-11-13 fix(c5vrx5): manual calibration is not refused on a live STRONG LANE step
    filter_request refused with "reset PHY experiments first" while STRONG LANE
    held a coarser lane. The calibration's pause already returns to the
    ultrafine lane before anything is measured.
    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
2026-11-13 fix(c5vrx5): STRONG LANE steps on the G2 floor row
    Board log (PR #304 build, LNA close in): runs of clipped windows on G2 with
    no lane step; every step was taken on G4. On G2 LEVEL asks for its lowest
    home row, G0, under the receiver floor, and the raw target read as room
    left, which reset the fold score every window. The target is now clamped
    to the floor before the comparison (strong_lane_no_room, host check in
    test_agc_strong.c). No board result for the fix yet.
    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
2026-11-13 fix(c5vrx5): STRONG LANE releases only a lane it routed itself
    Review finding: receiver_pause called strong_release unconditionally, and
    strong_release rerouted any non-ultrafine lane, so a scan or calibration
    silently cancelled a boot lane chosen with EXPERIMENTAL > IQ LANE. It now
    returns unless STRONG LANE owns the lane (steps > 0).
    Also stamp a lane step with the observation's own clock: the next ticks
    compare against observed_us, and the later esp_timer value could make the
    unsigned dwell difference wrap.
    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
2026-11-13 docs(c5vrx5): correct the AFC reading of the LNA board logs
    cfo_khz is the raw porch frequency; the target is -1000 kHz, so the logs
    show a 0.1-0.2 MHz residual, not a 1.2 MHz offset.
    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
2026-11-14 fix(c5vrx5): RX_LEVEL takes its noise from the C/N-AUTO map (with or without an LNA)
    The received-level meter learned its noise only at the table maximum and
    within -3..+4 dB of the -96.7 dBm calibration. Behind an external LNA
    (~21 dB, board 2026-11-14, A1, 12 MHz filter, VTX off) the AGC held
    G65-G67 and the pin noise was 17.5 dB over the calibration, so it never
    learned: the noise read as a -79.5 dBm carrier with 17 dB C/N on the menu
    and in the flight log. C/N-AUTO's per-row noise map was right on the same
    board.
    rx_level_noise_from_map() takes the highest row of the current
    channel/filter map that measured real noise and refers its thermal share
    to the pin with the gain model, as the p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
2026-11-14 fix(c5vrx5): LEVEL noise from the C/N-AUTO map; homes start under the LNA noise
    Behind an external LNA (~21 dB, board 2026-11-14, VTX off) LEVEL held G72
    and folded in 5155 of 5239 decisions; RX_LEVEL read unknown (every probe
    clipped). Its noise at the top row came from the boot gain table (only
    rows whose noise does not clip, so no G83 behind an LNA) or the bare
    default 4.8 cells^2, ~17 dB under the real noise: the noise read as a
    carrier and the homes ran from G83.
    - LEVEL's noise_top comes from the C/N-AUTO map of the channel/filter
    (rolled at 1 Hz with RX_LEVEL; re-bound when it moves over ~1 dB), then
    the gain table, then the default.
    - The homes start at the highest row whose noi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
2026-11-14 fix(c5vrx5): C/N-AUTO learns no-carrier noise only from unclipped windows
    Board 2026-11-14 (external ~21 dB LNA, VTX off, gain MAX): G83 folded every
    window, cna_carrier_absent passed and the folded samples were learned as
    row 83's noise; RX_LEVEL read a false 10.8 dB carrier again. The learning
    window (256 probes) now counts clipped/folded probes and is refused above
    2 %, the estimate's CNA_F_CLIPPED limit. CN_AUTO prints clip_rejects.
    Same sweep, fixed gains G54/G60/G66: pin-referred noise -79.2..-79.5 dBm,
    within 0.3 dB over 12 dB of gain: the noise enters before the gain rows.
2026-11-14 fix(c5vrx5): range diagnosis uses the useful gain top, not the table maximum
    Behind an external LNA the receiver's sensitive state is the highest row
    whose noise does not fold (~G67 on the 2026-11-14 board), never G83: the
    RANGE_DIAG verdicts (POSSIBLE_RF_FLOOR, WEAK_CARRIER, VIDEO_EVIDENCE
    headroom) and the dropout classifier's at-max/fade checks never fired.
    receiver_gain_top() gives that row from the C/N-AUTO map noise
    (LEVEL_TOP_NOISE_MAX_X16, now in agc.h, shared with LEVEL); the table
    maximum without a map value or on a bare board. RANGE_DIAG gain prints
    useful_top=.
2026-11-14 fix(c5vrx5): clipped windows bound the noise; EXPERIMENTAL > LEVEL TOP
    Board 2026-11-14 (flash of the LEVEL fix, ~22 dB LNA, VTX off): LEVEL bound
    the default 4.8 cells^2 and parked on G72, where every C/N-AUTO learning
    window clipped and was refused (clip_rejects rising, rows_with_noise=0): no
    map row, no reference, 17701 folds and no move. A clipped window's power is
    now kept per row for 5 s as a lower bound (never stored, no kurtosis test:
    clipping lowers it, and a row that clips has too much power with or without
    a carrier). With no clean map row the lowest such row sets the noise; a
    clean row learned under the top replaces it. Board after the fix: G66 at
    boot.
    EXPERIMENTAL > LEVEL TOP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
2026-11-14 fix(c5vrx5): shared DC model in the live servo; calibration and noise learning behind an LNA
    Shared DC model (dc_servo.h dc_model_t): the live trim of a gain row is
    shared + local(row). A step on a row whose codes are its own (calibrated or
    adopted) or that has settled is drift and moves every row at once; a step
    on an unsettled template row is its own, and template rows without one
    inherit the nearest row's. A row whose shared steps do not settle it (3
    strikes) turns local, so rows cannot fight over the shared part. Adoption
    keeps the offset and what neighbours inherit; the old first adoption pinned
    every row, after which no correction was shared at all. Blackbox session
    378 (~22 dB LNA): D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
2026-11-14 fix(c5vrx5): the noise map follows an LNA fitted or removed
    The no-carrier learning only takes a row within +0.5/-2 dB of the noise it
    knows: a map learned with the external LNA never followed its removal (17
    dB lower) and a map learned bare never took the LNA's noise. A carrier
    cannot move the noise that far (a weak one adds under ~1 dB, a strong one
    fails the kurtosis test, none lowers it), so a noise-like unclipped window
    more than 6 dB over or 2 dB under the noise the map expects at the row, or
    a clipped no-video window more than 6 dB over it (a lower bound), rebases
    the whole map by the same thermal ratio and drops its anchors.
    CN_AUTO prints rebases=. Host: test_cn_auto (LNA fitted / r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
2026-11-14 docs: external LNA support in the README (Zeenko ZK06-UM)
    PR #306/#307 made C5VRX-5 follow an external LNA by itself (noise map,
    useful gain top, LEVEL, shared DC model). The README gets a hardware
    section: wiring and arrow direction, no setting needed, what it measured
    (system NF ~6 -> ~1 dB; a first indoor walk held the picture to ~6.5 dB
    weaker signals), close-in notes, and the tested module with its photo
    and an affiliate link, disclosed as such.
